DerFetzer/home-media-converter/hw/home-media-converter.ods

 | NumBoards | 5
# | Reference | Qty | Value | Footprint | QtyTotal | PN | Link
1 | C1, C2, C3, C4, C8, C9, C10, C18, C20, C22, C23, C26, C27, C29, C32, C34, C38, C39, C40, C41, C51, C52, C53, C54, C55 | 25 | 100n | Capacitor_SMD:C_0402_1005Metric | 125 | 1276-1043-1-ND | https://www.digikey.de/de/products/detail/samsung-electro-mechanics/CL05A104KA5NNNC/3886701
2 | C5, C17, C19, C24, C28, C36 | 6 | 10u | Capacitor_SMD:C_0402_1005Metric | 30 | 490-GRM155R61A106ME11DCT-ND | https://www.digikey.de/de/products/detail/murata-electronics/GRM155R61A106ME11D/12091056
3 | C6, C7, C14, C15 | 4 | 26p | Capacitor_SMD:C_0402_1005Metric | 20 | 490-GCM1555C1H270FA16JCT-ND | https://www.digikey.de/de/products/detail/murata-electronics/GCM1555C1H270FA16J/11618592
4 | C11, C37, C42, C56 | 4 | 4u7 | Capacitor_SMD:C_0402_1005Metric | 20 | 1276-1482-1-ND | https://www.digikey.de/de/products/detail/samsung-electro-mechanics/CL05A475MP5NRNC/3887140
5 | C12, C13 | 2 | 100n 1% | Capacitor_SMD:C_0402_1005Metric | 10 | 13-CC0402JRX7R8BB104CT-ND | https://www.digikey.de/de/products/detail/yageo/CC0402JRX7R8BB104/11491448
6 | C16 | 1 | 4n7 | Capacitor_SMD:C_1206_3216Metric | 5 | 732-12074-1-ND | https://www.digikey.de/de/products/detail/w%C3%BCrth-elektronik/885342208020/9345886
7 | C21, C25, C30, C35, C43, C44, C45, C62, C63 | 9 | 22u | Capacitor_SMD:C_0603_1608Metric | 45 | 1276-1274-1-ND | https://www.digikey.de/de/products/detail/samsung-electro-mechanics/CL10A226MP8NUNE/3886932
8 | C31, C46, C47, C48, C49, C50 | 6 | 10n | Capacitor_SMD:C_0402_1005Metric | 30 | 478-1114-1-ND | https://www.digikey.de/de/products/detail/kyocera-avx/0402YC103KAT2A/563224
9 | C57, C58, C60, C61 | 4 | 2u2 | Capacitor_SMD:C_0402_1005Metric | 20 | 478-CM05X5R225M16AHCT-ND | https://www.digikey.de/de/products/detail/kyocera-avx/CM05X5R225M16AH/10815099
10 | D1, D2 | 2 | 1N4148W | Diode_SMD:D_SOD-123 | 10 | 1N4148WXTPMSCT-ND | https://www.digikey.de/de/products/detail/micro-commercial-co/1N4148WX-TP/717197
11 | D3, D4, D5, D6 | 2 | LED | LED_SMD:LED_0603_1608Metric | 10 | 3147-B1911USD-20D000114U1930CT-ND | https://www.digikey.de/de/products/detail/harvatek-corporation/B1911USD-20D000114U1930/15519991
11 | D3, D4, D5, D6 | 2 | LED | LED_SMD:LED_0603_1608Metric | 10 | 3147-B1911PG--20D000514U1930CT-ND | https://www.digikey.de/de/products/detail/harvatek-corporation/B1911PG-20D000514U1930/15519992
11 | D3, D4, D5, D6 | 2 | LED | LED_SMD:LED_0603_1608Metric | 10 | 3147-B1911UYG-20D000114U1930CT-ND | https://www.digikey.de/de/products/detail/harvatek-corporation/B1911UYG-20D000114U1930/15519990
11 | D3, D4, D5, D6 | 2 | LED | LED_SMD:LED_0603_1608Metric | 10 | 3147-B1931NB--20C007614U1930CT-ND | https://www.digikey.de/de/products/detail/harvatek-corporation/B1931NB-20C007614U1930/15861263
12 | F1 | 1 | Fuse | Fuse:Fuse_0603_1608Metric | 5 | 2315-FMC16252WHTPCT-ND | https://www.digikey.de/de/products/detail/kamaya-inc/FMC16252WHTP/15181193
13 | FB1, FB2, FB3, FB4, FB5, FB6 | 3 | BLM18PG121SN1D | Inductor_SMD:L_0603_1608Metric | 15 | 490-1037-1-ND | https://www.digikey.de/de/products/detail/murata-electronics/BLM18PG121SN1D/584248
13 | FB1, FB2, FB3, FB4, FB5, FB6 | 2 | BLM18KG601SH1D | Inductor_SMD:L_0603_1608Metric | 10 | 490-13259-1-ND | https://www.digikey.de/de/products/detail/murata-electronics/BLM18KG601SH1D/5881248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
13 | FB1, FB2, FB3, FB4, FB5, FB6 | 1 | BLM18HE102SN1D | Inductor_SMD:L_0603_1608Metric | 5 | 490-5215-1-ND | https://www.digikey.de/de/products/detail/murata-electronics/BLM18HE102SN1D/1948320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
15 | J1 | 1 | 0826-1X1T-32-F | project_lib:0826-1X1T-32-F | 5 | 507-1606-ND | https://www.digikey.de/de/products/detail/bel-fuse-inc/0826-1X1T-32-F/2257873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
18 | J6 | 1 | RJ45_LED_Shielded | Connector_RJ:RJ45_Amphenol_RJHSE538X | 5 | RJHSE-5381-ND | https://www.digikey.de/de/products/detail/amphenol-cs-commercial-products/RJHSE-5381/1242694
19 | J7 | 1 | USB_B | Connector_USB:USB_Micro-B_Wuerth_629105150521 | 5 | 732-5960-1-ND | https://www.digikey.de/de/products/detail/w%C3%BCrth-elektronik/629105150521/5047751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
20 | L1 | 1 | CMC | project_lib:DLW32MH101XK2L | 5 | 490-18059-1-ND | https://www.digikey.de/de/products/detail/murata-electronics/DLW32MH101XK2L/9559534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
21 | L2, L3, L4 | 3 | 1u | Inductor_SMD:L_1008_2520Metric | 15 | 490-13053-1-ND | https://www.digikey.de/de/products/detail/murata-electronics/DFE252012F-1R0M-P2/5812589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
22 | R1, R2, R9, R10, R42, R43, R44, R45 | 8 | 470 | Resistor_SMD:R_0402_1005Metric | 40 | 2019-RK73H1ETTP4700FCT-ND | https://www.digikey.de/de/products/detail/koa-speer-electronics-inc/RK73H1ETTP4700F/9844116
23 | R3, R4, R5, R8, R12, R13 | 6 | 10k | Resistor_SMD:R_0402_1005Metric | 30 | 2019-RK73B1ETTP103JCT-ND | https://www.digikey.de/de/products/detail/koa-speer-electronics-inc/RK73B1ETTP103J/9843960
24 | R6 | 1 | 4k7 | Resistor_SMD:R_0402_1005Metric | 5 | P4.70KLCT-ND | https://www.digikey.de/de/products/detail/panasonic-electronic-components/ERJ-2RKF4701X/1746231
25 | R7 | 1 | 6k04 | Resistor_SMD:R_0402_1005Metric | 5 | 2019-RK73H1ETTP6041FCT-ND | https://www.digikey.de/de/products/detail/koa-speer-electronics-inc/RK73H1ETTP6041F/9844122
27 | R11, R14, R15, R16 | 4 | 1k | Resistor_SMD:R_0402_1005Metric | 20 | 2019-RK73H1ETTP1001FCT-ND | https://www.digikey.de/de/products/detail/koa-speer-electronics-inc/RK73H1ETTP1001F/9844155
28 | R17, R33, R35 | 3 | 2k2 | Resistor_SMD:R_0402_1005Metric | 15 | P2.20KLCT-ND | https://www.digikey.de/de/products/detail/panasonic-electronic-components/ERJ-2RKF2201X/1746150
29 | R18, R19, R20, R21, R22, R23, R24, R25, R26, R27, R28, R29 | 12 | 22 | Resistor_SMD:R_0402_1005Metric | 60 | P22.0LCT-ND | https://www.digikey.de/de/products/detail/panasonic-electronic-components/ERJ-2RKF22R0X/1746157
30 | R30, R31, R32, R39, R40, R41 | 6 | 2k49 | Resistor_SMD:R_0402_1005Metric | 30 | 2019-RK73H1ETTP2491FCT-ND | https://www.digikey.de/de/products/detail/koa-speer-electronics-inc/RK73H1ETTP2491F/9844088
31 | R34 | 1 | 13k | Resistor_SMD:R_0402_1005Metric | 5 | 2019-RK73H1ETTP1302FCT-ND | https://www.digikey.de/de/products/detail/koa-speer-electronics-inc/RK73H1ETTP1302F/9844135
32 | R36, R37 | 2 | 1k 1% | Resistor_SMD:R_1206_3216Metric | 10 | 311-1.00KFRCT-ND | https://www.digikey.de/de/products/detail/yageo/RC1206FR-071KL/728387
33 | R38 | 1 | 100k | Resistor_SMD:R_0805_2012Metric | 5 | RMCF0805FT100KCT-ND | https://www.digikey.de/de/products/detail/stackpole-electronics-inc/RMCF0805FT100K/1760712
34 | R46 | 1 | 200k | Resistor_SMD:R_0402_1005Metric | 5 | 13-AC0402FR-7W200KLCT-ND | https://www.digikey.de/de/products/detail/yageo/AC0402FR-7W200KL/12698840
35 | R47, R48, R49 | 3 | 100k | Resistor_SMD:R_0402_1005Metric | 15 | P100KLCT-ND | https://www.digikey.de/de/products/detail/panasonic-electronic-components/ERJ-2RKF1003X/192081
36 | SW1 | 1 | SW_Push | Button_Switch_SMD:SW_Push_1P1T_NO_CK_KMR2 | 5 | 401-1426-1-ND | https://www.digikey.de/de/products/detail/c-k/KMR211GLFS/550475
37 | U1 | 1 | KSZ9131RNXC-TR | project_lib:KSZ9131RNXC-TR | 5 | 150-KSZ9131RNXC-CT-ND | https://www.digikey.de/de/products/detail/microchip-technology/KSZ9131RNXC-TR/10673417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
38 | U2 | 1 | STM32F030F4Px | Package_SO:TSSOP-20_4.4x6.5mm_P0.65mm | 5 | 497-17333-1-ND | https://www.digikey.de/de/products/detail/stmicroelectronics/STM32F030F4P6TR/4755941
39 | U3 | 1 | DP83TG720RWRHATQ1 | project_lib:DP83TG720RWRHATQ1 | 5 | 296-DP83TG720RWRHATQ1CT-ND | https://www.digikey.de/de/products/detail/texas-instruments/DP83TG720RWRHATQ1/14004381
40 | U4 | 1 | AP63203WU | Package_TO_SOT_SMD:TSOT-23-6 | 5 | AP63203WU-7DICT-ND | https://www.digikey.de/de/products/detail/diodes-incorporated/AP63203WU-7/9858426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
41 | U5, U7 | 2 | TPS62A01ADRLR | project_lib:TPS62A01ADRLR | 10 | 296-TPS62A01ADRLRCT-ND | https://www.digikey.de/de/products/detail/texas-instruments/TPS62A01ADRLR/16582361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
42 | U6 | 1 | TPS784105QWDRBRQ1 | project_lib:TPS784105QWDRBRQ1 | 5 | 296-TPS784105QWDRBRQ1CT-ND | https://www.digikey.de/de/products/detail/texas-instruments/TPS784105QWDRBRQ1/14123989
43 | Y1, Y2 | 2 | 25MHz | Crystal:Crystal_SMD_5032-2Pin_5.0x3.2mm | 10 | 2151-H130A-25.000-18-F-2030-EXT-TRCT-ND | https://www.digikey.de/de/products/detail/raltron-electronics/H130A-25-000-18-F-2030-EXT-TR/10272262
