DerFetzer/home-media-converter/hw/housing/Lid (Meshed).stl

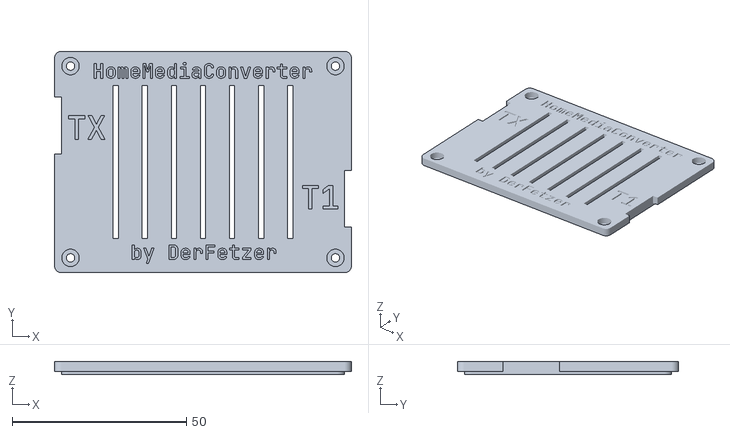
[picture p1: CAD file, 2023-04-26]
hw/housing/Lid (Meshed).stl
85.2 x 63.5 x 3.80
