DerFetzer/home-media-converter/hw/housing/HomeMediaConverterHousing.FCStd

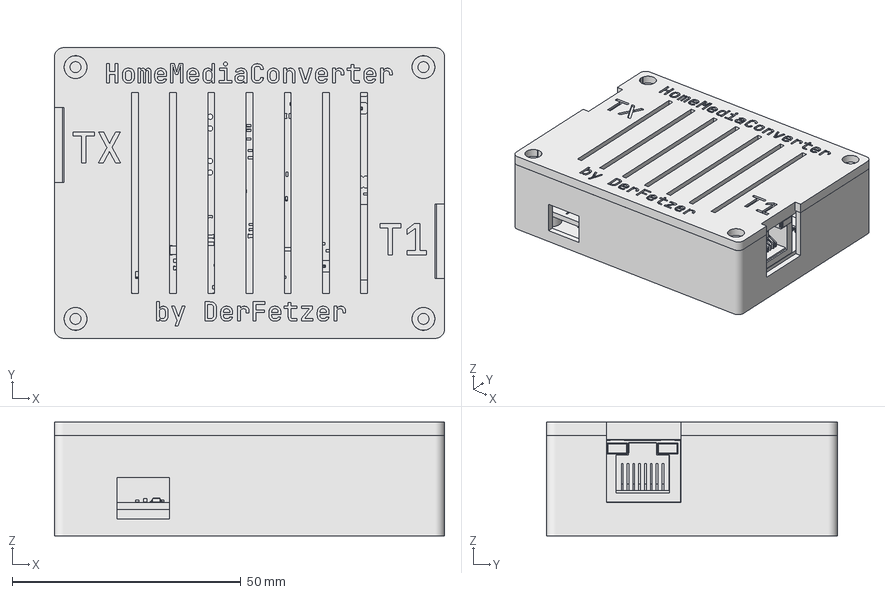
[picture p2: CAD file, 2023-04-26]
hw/housing/HomeMediaConverterHousing.FCStd
85.2 x 63.5 x 24.8 mm
Lid
home-media-converter
Lid (Meshed)
Bottom (Meshed)
