DerFetzer/home-media-converter/hw/housing/Bottom (Meshed).stl

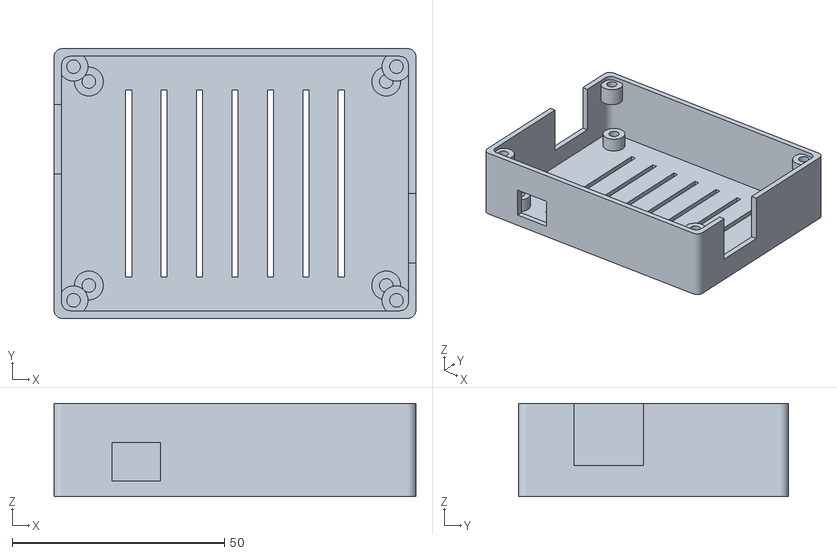
[picture p3: CAD file, 2023-04-26]
hw/housing/Bottom (Meshed).stl
85.2 x 63.5 x 21.9
