DerFetzer/home-media-converter/hw/pcb/home-media-converter.kicad_pcb

## KiCad design hw/pcb/home-media-converter.kicad_pcb (2023-05-08)

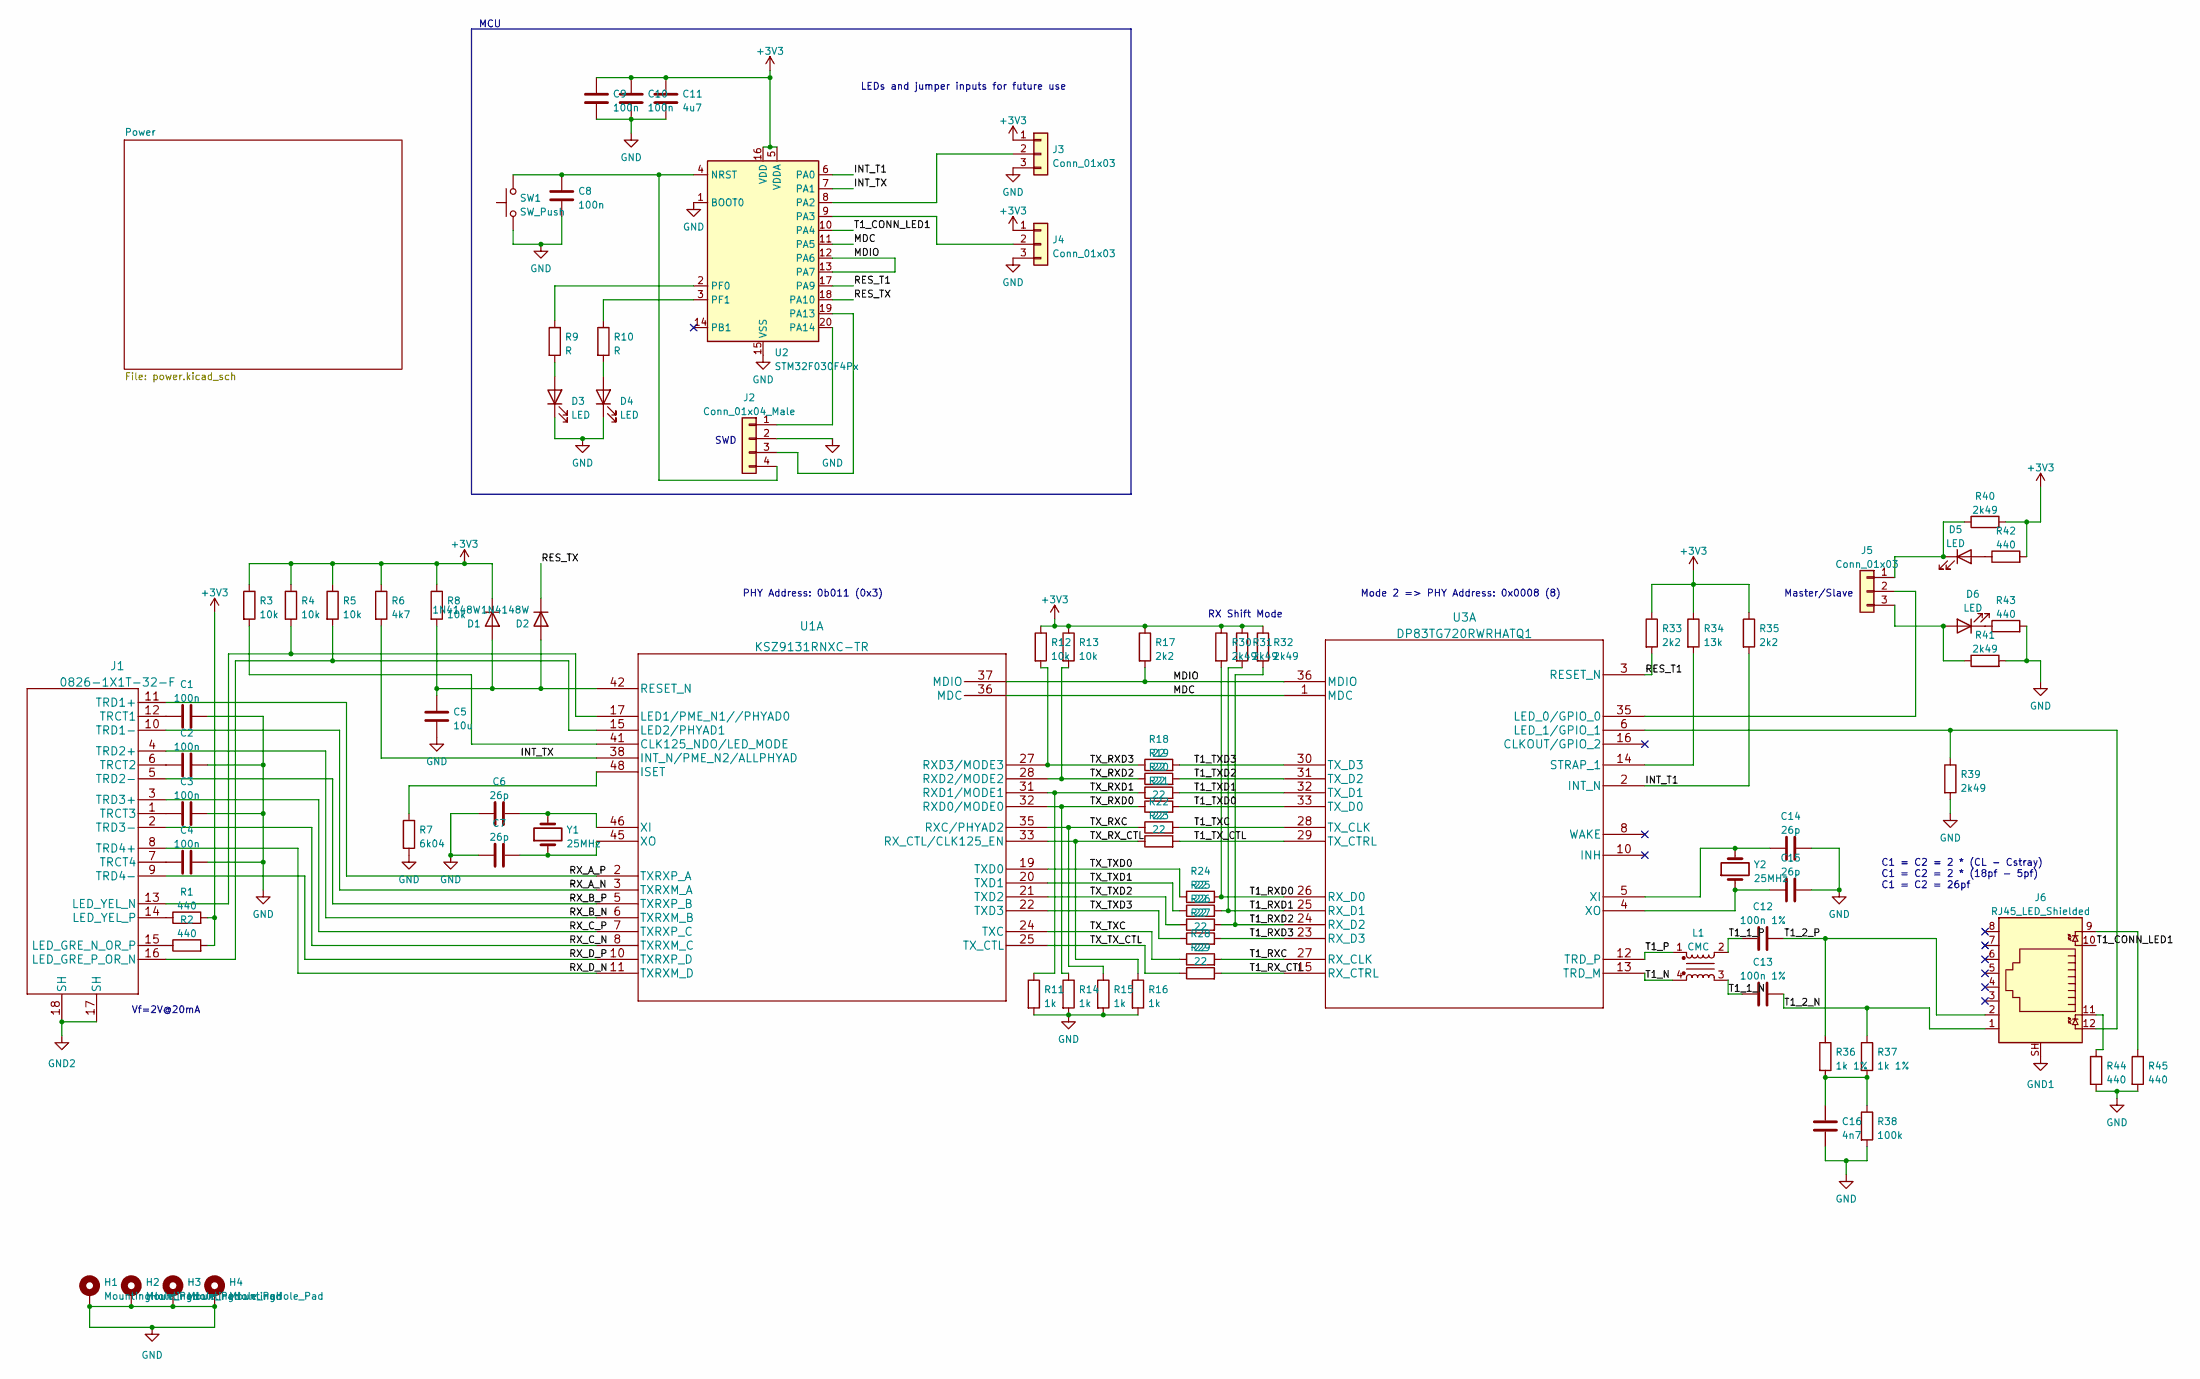
[picture p4: schematic home-media-converter.kicad_sch]

Parts:
C1, C2, C3, C4, C8, C9, C10: 100n; C_0402_1005Metric
C5: 10u; C_0402_1005Metric
C6, C7, C14, C15: 26p; C_0402_1005Metric
C11: 4u7; C_0402_1005Metric
C12, C13: 100n 1%; C_0402_1005Metric
C16: 4n7; C_1206_3216Metric
D1, D2: 1N4148W; D_SOD-123
D3, D4, D5, D6: LED; LED_0603_1608Metric
H1, H2, H3, H4: MountingHole_Pad; MountingHole_2.2mm_M2_DIN965_Pad_TopBottom
J1: 0826-1X1T-32-F
J2: Conn_01x04_Male; PinHeader_1x04_P2.54mm_Vertical
J3, J4, J5: Conn_01x03; PinHeader_1x03_P2.54mm_Vertical
J6: RJ45_LED_Shielded; RJ45_Amphenol_RJHSE538X
L1: CMC; DLW32MH101XK2L
R1, R2, R42, R43, R44, R45: 440; R_0402_1005Metric
R3, R4, R5, R8, R12, R13: 10k; R_0402_1005Metric
R6: 4k7; R_0402_1005Metric
R7: 6k04; R_0402_1005Metric
R9, R10: R; R_0402_1005Metric
R11, R14, R15, R16: 1k; R_0402_1005Metric
R17, R33, R35: 2k2; R_0402_1005Metric
R18, R19, R20, R21, R22, R23, R24, R25, R26, R27, R28, R29: 22; R_0402_1005Metric
R30, R31, R32, R39, R40, R41: 2k49; R_0402_1005Metric
R34: 13k; R_0402_1005Metric
R36, R37: 1k 1%; R_1206_3216Metric
R38: 100k; R_0805_2012Metric
SW1: SW_Push; SW_Push_1P1T_NO_CK_KMR2
U1: KSZ9131RNXC-TR
U2: STM32F030F4Px; TSSOP-20_4.4x6.5mm_P0.65mm
U3: DP83TG720RWRHATQ1
Y1, Y2: 25MHz; Crystal_SMD_5032-2Pin_5.0x3.2mm

Connections:
+3V3: C9.1, C10.1, C11.1, D1.1 (K), J3.1, J4.1, R1.2, R2.2, R3.1, R4.1, R5.1, R6.1, R8.1, R12.1, R13.1, R17.1, R30.1, R31.1, R32.1, R33.1, R34.1, R35.1, R40.2, R42.2, U2.5 (VDDA), U2.16 (VDD); also elsewhere on the board
/INT_T1: R35.2, U2.6 (PA0), U3.2 (INT_N)
/INT_TX: R6.2, U1.38 (INT_N/PME_N2/ALLPHYAD), U2.7 (PA1)
/MDC: U1.36 (MDC), U2.11 (PA5), U3.1 (MDC)
/MDIO: R17.2, U1.37 (MDIO), U2.12 (PA6), U2.13 (PA7), U3.36 (MDIO)
/RES_T1: R33.2, U2.17 (PA9), U3.3 (RESET_N)
/RES_TX: D2.1 (K), U2.18 (PA10)
/RX_A_N: J1.10 (TRD1-), U1.3 (TXRXM_A); also elsewhere on the board
/RX_A_P: J1.11 (TRD1+), U1.2 (TXRXP_A); also elsewhere on the board
/RX_B_N: J1.4 (TRD2+), U1.6 (TXRXM_B); also elsewhere on the board
/RX_B_P: J1.5 (TRD2-), U1.5 (TXRXP_B); also elsewhere on the board
/RX_C_N: J1.2 (TRD3-), U1.8 (TXRXM_C); also elsewhere on the board
/RX_C_P: J1.3 (TRD3+), U1.7 (TXRXP_C); also elsewhere on the board
/RX_D_N: J1.8 (TRD4+), U1.11 (TXRXM_D); also elsewhere on the board
/RX_D_P: J1.9 (TRD4-), U1.10 (TXRXP_D); also elsewhere on the board
/T1_1_N: C13.1, L1.3
/T1_1_P: C12.1, L1.2
/T1_2_N: C13.2, J6.1, R37.1
/T1_2_P: C12.2, J6.2, R36.1
/T1_CONN_LED1: J6.10, U2.10 (PA4)
/T1_N: L1.4, U3.13 (TRD_M)
/T1_P: L1.1, U3.12 (TRD_P)
/T1_RXC: R28.2, U3.27 (RX_CLK)
/T1_RXD0: R24.2, R30.2, U3.26 (RX_D0)
/T1_RXD1: R25.2, R31.2, U3.25 (RX_D1)
/T1_RXD2: R26.2, R32.2, U3.24 (RX_D2)
/T1_RXD3: R27.2, U3.23 (RX_D3)
/T1_RX_CTL: R29.2, U3.15 (RX_CTRL)
/T1_TXC: R22.2, U3.28 (TX_CLK)
/T1_TXD0: R21.2, U3.33 (TX_D0)
/T1_TXD1: R20.2, U3.32 (TX_D1)
/T1_TXD2: R19.2, U3.31 (TX_D2)
/T1_TXD3: R18.2, U3.30 (TX_D3)
/T1_TX_CTL: R23.2, U3.29 (TX_CTRL)
/TX_RXC: R15.1, R22.1, U1.35 (RXC/PHYAD2)
/TX_RXD0: R14.1, R21.1, U1.32 (RXD0/MODE0)
/TX_RXD1: R11.1, R20.1, U1.31 (RXD1/MODE1)
/TX_RXD2: R13.2, R19.1, U1.28 (RXD2/MODE2)
/TX_RXD3: R12.2, R18.1, U1.27 (RXD3/MODE3)
/TX_RX_CTL: R16.1, R23.1, U1.33 (RX_CTL/CLK125_EN)
/TX_TXC: R28.1, U1.24 (TXC)
/TX_TXD0: R24.1, U1.19 (TXD0)
/TX_TXD1: R25.1, U1.20 (TXD1)
/TX_TXD2: R26.1, U1.21 (TXD2)
/TX_TXD3: R27.1, U1.22 (TXD3)
/TX_TX_CTL: R29.1, U1.25 (TX_CTL)
GND: C1.2, C2.2, C3.2, C4.2, C5.2, C6.1, C7.1, C8.2, C9.2, C10.2, C11.2, C14.2, C15.2, C16.2, D3.1 (K), D4.1 (K), H1.1, H2.1, H3.1, H4.1, J2.2, J3.3, J4.3, R7.2, R11.2, R14.2, R15.2, R16.2, R38.2, R39.2, R41.2, R43.2, R44.2, R45.2, SW1.1, U2.1 (BOOT0), U2.15 (VSS); also elsewhere on the board
GND1: J6.SH
unnamed: C16.1, R36.2, R37.2, R38.1
unnamed: C5.1, D1.2 (A), D2.2 (A), R8.2, U1.42 (RESET_N)
unnamed: D3.2 (A), R9.2
unnamed: D4.2 (A), R10.2
unnamed: D5.2 (A), R42.1
unnamed: D5.1 (K), J5.1, R40.1
unnamed: D6.2 (A), J5.3, R41.1
unnamed: D6.1 (K), R43.1
unnamed 66: J1.15 (LED_GRE_N_OR_P), R2.1; also elsewhere on the board
unnamed 67: J1.16 (LED_GRE_P_OR_N), R5.2, U1.15 (LED2/PHYAD1); also elsewhere on the board
unnamed 68: J1.13 (LED_YEL_N), R4.2, U1.17 (LED1/PME_N1//PHYAD0); also elsewhere on the board
unnamed 69: J1.14 (LED_YEL_P), R1.1; also elsewhere on the board
unnamed: J1.17 (SH), J1.18 (SH)
unnamed 71: C1.1, J1.12 (TRCT1); also elsewhere on the board
unnamed 72: C2.1, J1.6 (TRCT2); also elsewhere on the board
unnamed 73: C3.1, J1.1 (TRCT3); also elsewhere on the board
unnamed 74: C4.1, J1.7 (TRCT4); also elsewhere on the board
unnamed: J2.1, U2.20 (PA14)
unnamed: J2.3, U2.19 (PA13)
unnamed: C8.1, J2.4, SW1.2, U2.4 (NRST)
unnamed: J3.2, U2.8 (PA2)
unnamed: J4.2, U2.9 (PA3)
unnamed: J5.2, U3.35 (LED_0/GPIO_0)
unnamed: J6.9, R45.1
unnamed: J6.11, R44.1
unnamed: R3.2, U1.41 (CLK125_NDO/LED_MODE)
unnamed: R7.1, U1.48 (ISET)
unnamed: C6.2, U1.46 (XI), Y1.2
unnamed: C7.2, U1.45 (XO), Y1.1
unnamed: R9.1, U2.2 (PF0)
unnamed: R10.1, U2.3 (PF1)
unnamed: J6.12, R39.1, U3.6 (LED_1/GPIO_1)
unnamed: R34.2, U3.14 (STRAP_1)
unnamed: C14.1, U3.5 (XI), Y2.2
unnamed: C15.1, U3.4 (XO), Y2.1

Notes on the sheet:
Vf=2V@20mA
LEDs and jumper inputs for future use
Mode 2 => PHY Address: 0x0008 (8)
C1 = C2 = 2 * (CL - Cstray) C1 = C2 = 2 * (18pf - 5pf) C1 = C2 = 26pf
SWD
RX Shift Mode
PHY Address: 0b011 (0x3)
MCU
Master/Slave

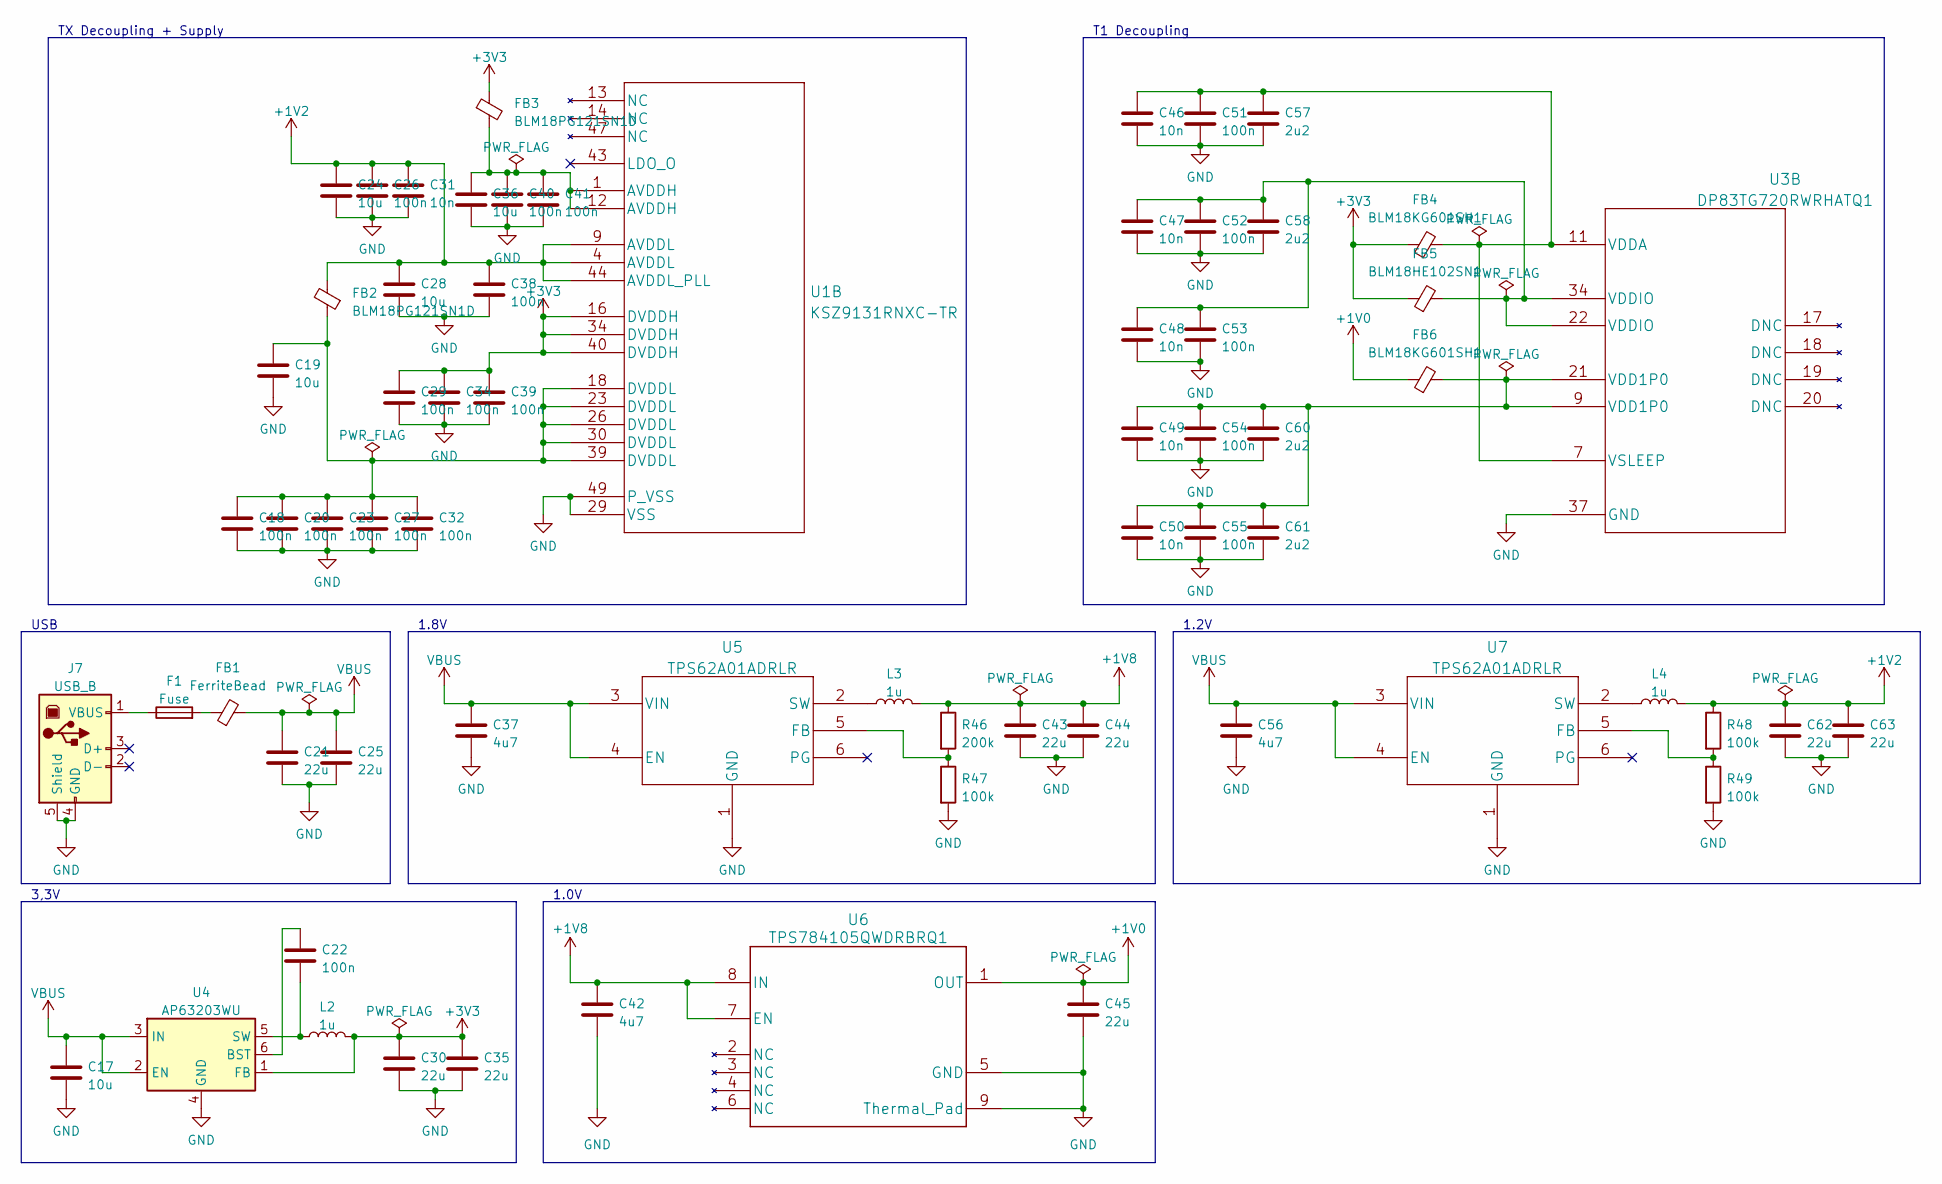
[picture p5: schematic power.kicad_sch]

Parts:
C17, C19, C24, C28, C36: 10u; C_0402_1005Metric
C18, C20, C22, C23, C26, C27, C29, C32, C34, C38, C39, C40, C41, C51, C52, C53, C54, C55: 100n; C_0402_1005Metric
C21, C25, C30, C35, C43, C44, C45, C62, C63: 22u; C_0603_1608Metric
C31, C46, C47, C48, C49, C50: 10n; C_0402_1005Metric
C37, C42, C56: 4u7; C_0402_1005Metric
C57, C58, C60, C61: 2u2; C_0402_1005Metric
F1: Fuse; Fuse_0603_1608Metric
FB1: FerriteBead; L_0603_1608Metric
FB2, FB3: BLM18PG121SN1D; L_0603_1608Metric
FB4, FB6: BLM18KG601SH1; L_0603_1608Metric
FB5: BLM18HE102SN1; L_0603_1608Metric
J7: USB_B; USB_Micro-B_Wuerth_629105150521
L2, L3, L4: 1u; L_1008_2520Metric
R46: 200k; R_0402_1005Metric
R47, R48, R49: 100k; R_0402_1005Metric
U1: KSZ9131RNXC-TR
U3: DP83TG720RWRHATQ1
U4: AP63203WU; TSOT-23-6
U5, U7: TPS62A01ADRLR
U6: TPS784105QWDRBRQ1

Connections:
+1V0: C45.1, FB6.1, U6.1 (OUT)
+1V2: C24.1, C26.1, C28.1, C31.1, C38.1, C62.1, C63.1, FB2.2, L4.2, R48.1, U1.4 (AVDDL), U1.9 (AVDDL), U1.44 (AVDDL_PLL)
+1V8: C42.1, C43.1, C44.1, L3.2, R46.1, U6.7 (EN), U6.8 (IN)
+3V3: C29.1, C30.1, C34.1, C35.1, C39.1, FB3.1, FB4.1, FB5.1, L2.2, U1.16 (DVDDH), U1.34 (DVDDH), U1.40 (DVDDH), U4.1 (FB); also elsewhere on the board
GND: C17.2, C18.2, C19.2, C20.2, C21.2, C23.2, C24.2, C25.2, C26.2, C27.2, C28.2, C29.2, C30.2, C31.2, C32.2, C34.2, C35.2, C36.2, C37.2, C38.2, C39.2, C40.2, C41.2, C42.2, C43.2, C44.2, C45.2, C46.2, C47.2, C48.2, C49.2, C50.2, C51.2, C52.2, C53.2, C54.2, C55.2, C56.2, C57.2, C58.2, C60.2, C61.2, C62.2, C63.2, J7.4 (GND), J7.5 (Shield), R47.2, R49.2, U1.29 (VSS), U1.49 (P_VSS), U3.37 (GND), U4.4 (GND), U5.1 (GND), U6.5 (GND), U6.9 (Thermal_Pad), U7.1 (GND); also elsewhere on the board
unnamed: C18.1, C19.1, C20.1, C23.1, C27.1, C32.1, FB2.1, U1.18 (DVDDL), U1.23 (DVDDL), U1.26 (DVDDL), U1.30 (DVDDL), U1.39 (DVDDL)
unnamed: C36.1, C40.1, C41.1, FB3.2, U1.1 (AVDDH), U1.12 (AVDDH)
unnamed: C46.1, C51.1, C57.1, FB4.2, U3.7 (VSLEEP), U3.11 (VDDA)
unnamed: C47.1, C48.1, C52.1, C53.1, C58.1, FB5.2, U3.22 (VDDIO), U3.34 (VDDIO)
unnamed: C49.1, C50.1, C54.1, C55.1, C60.1, C61.1, FB6.2, U3.9 (VDD1P0), U3.21 (VDD1P0)
unnamed: F1.2, FB1.1
unnamed: F1.1, J7.1 (VBUS)
unnamed: C22.1, U4.6 (BST)
unnamed: C22.2, L2.1, U4.5 (SW)
unnamed: R46.2, R47.1, U5.5 (FB)
unnamed: L3.1, U5.2 (SW)
unnamed: R48.2, R49.1, U7.5 (FB)
unnamed: L4.1, U7.2 (SW)
VBUS: C17.1, C21.1, C25.1, C37.1, C56.1, FB1.2, U4.2 (EN), U4.3 (IN), U5.3 (VIN), U5.4 (EN), U7.3 (VIN), U7.4 (EN)

Notes on the sheet:
USB
TX Decoupling + Supply
1.0V
1.2V
3,3V
1.8V
T1 Decoupling

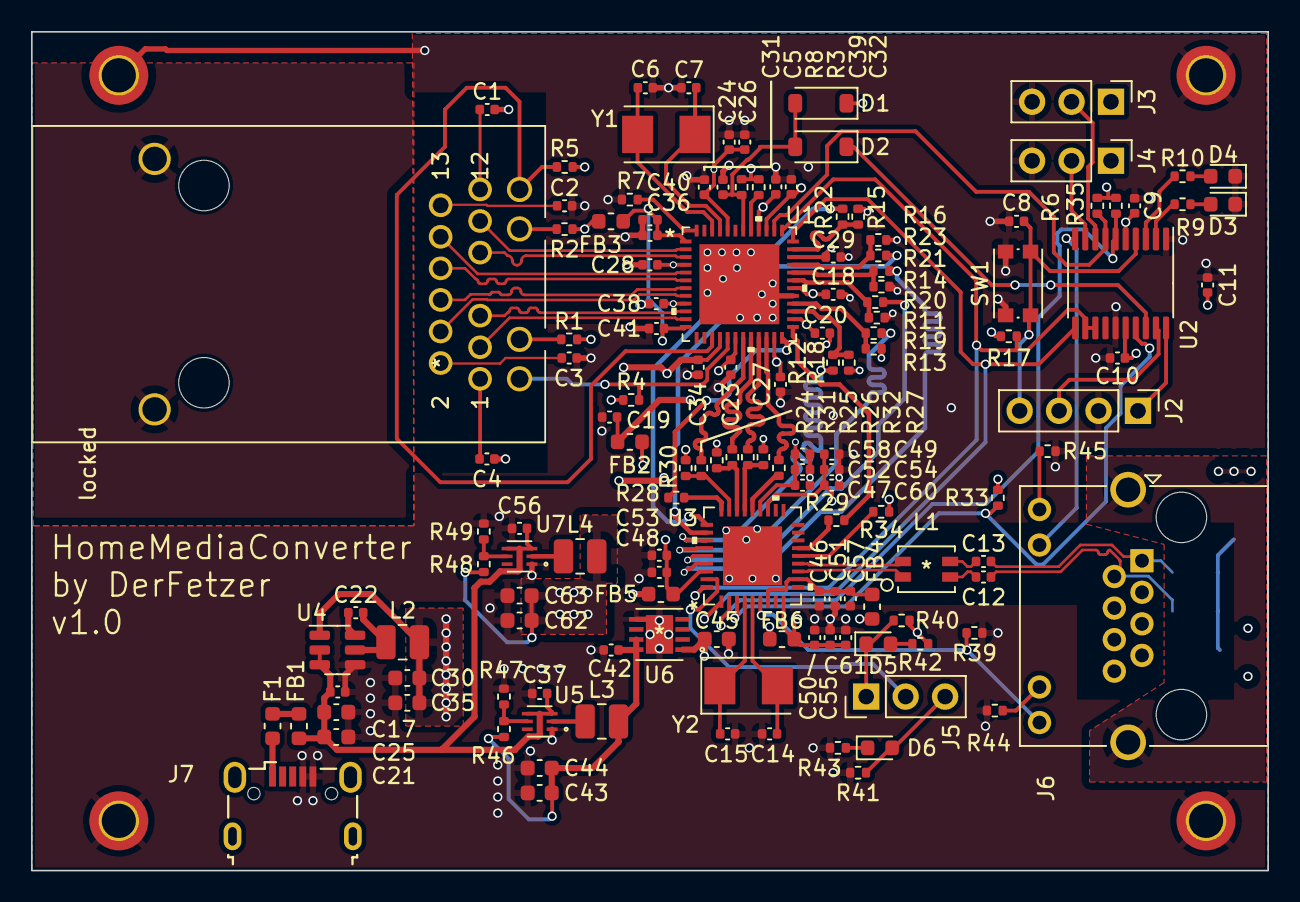
[picture p6: board home-media-converter.kicad_pcb from above]

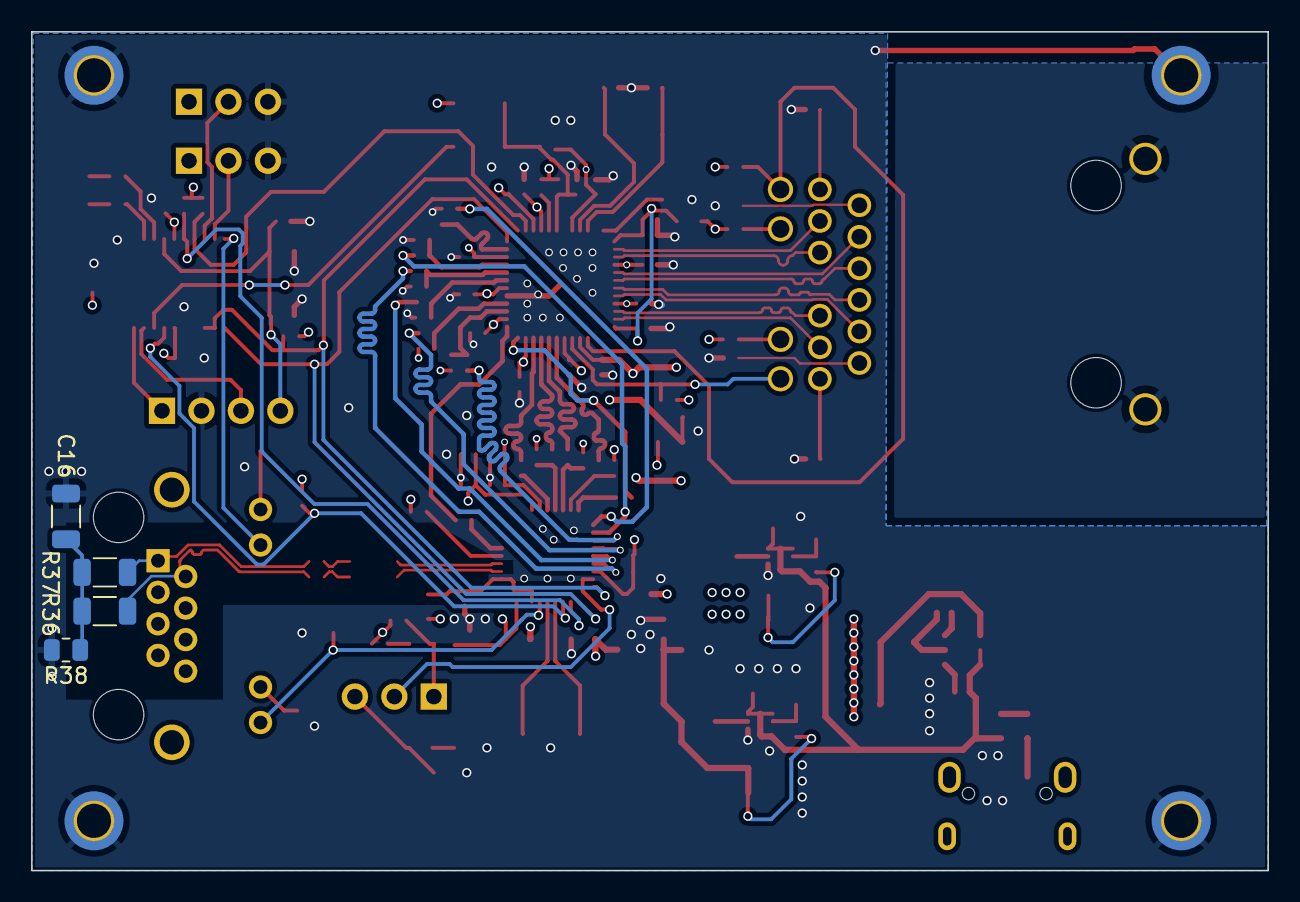
[picture p7: board home-media-converter.kicad_pcb from below]

Board: 4 copper layers, 79.6 x 54.0 mm, 148 parts (4 on the bottom side), 99 nets.

Other parts of the board:
locked: 0826-1X1T-32-F

Their connections:
/RX_A_N: locked.10 (TRD1-); also elsewhere on the board
/RX_A_P: locked.11 (TRD1+); also elsewhere on the board
/RX_B_N: locked.4 (TRD2+); also elsewhere on the board
/RX_B_P: locked.5 (TRD2-); also elsewhere on the board
/RX_C_N: locked.2 (TRD3-); also elsewhere on the board
/RX_C_P: locked.3 (TRD3+); also elsewhere on the board
/RX_D_N: locked.8 (TRD4+); also elsewhere on the board
/RX_D_P: locked.9 (TRD4-); also elsewhere on the board
GND2: locked.17 (SH), locked.18 (SH)
unnamed 66: locked.15 (LED_GRE_N_OR_P); also elsewhere on the board
unnamed 67: locked.16 (LED_GRE_P_OR_N); also elsewhere on the board
unnamed 68: locked.13 (LED_YEL_N); also elsewhere on the board
unnamed 69: locked.14 (LED_YEL_P); also elsewhere on the board
unnamed 71: locked.12 (TRCT1); also elsewhere on the board
unnamed 72: locked.6 (TRCT2); also elsewhere on the board
unnamed 73: locked.1 (TRCT3); also elsewhere on the board
unnamed 74: locked.7 (TRCT4); also elsewhere on the board
