DerFetzer/home-media-converter/(commit log)

2023-03-29 Initial PCB design
    [home-media-converter.kicad_pcb, home-media-converter.kicad_sch, power.kicad_sch]
2023-03-30 Bigger components on MDI
    [home-media-converter.kicad_pcb, home-media-converter.kicad_sch]
2023-03-30 Add production files
    [home-media-converter-B_Cu.gbl, home-media-converter-B_Mask.gbs, home-media-converter-B_Paste.gbp, home-media-converter-B_Silkscreen.gbo, home-media-converter-Edge_Cuts.gm1, home-media-converter-F_Cu.gtl, home-media-converter-F_Mask.gts, home-media-converter-F_Paste.gtp]
2023-03-30 Plot params
    [home-media-converter.kicad_pcb]
2023-04-05 Set missing part values, create BOM
    [home-media-converter.kicad_sch, home-media-converter.ods, power.kicad_sch]
2023-04-21 Fix MagJack LED polarity
    [home-media-converter.kicad_pcb, home-media-converter.kicad_sch]
2023-04-23 Slower blinking of SQI LED
2023-04-23 Move PCB to subdirectory
    [home-media-converter-B_Cu.gbl, home-media-converter-B_Mask.gbs, home-media-converter-B_Paste.gbp, home-media-converter-B_Silkscreen.gbo, home-media-converter-Edge_Cuts.gm1, home-media-converter-F_Cu.gtl, home-media-converter-F_Mask.gts, home-media-converter-F_Paste.gtp]
2023-04-26 Add housing
    [Bottom (Meshed).stl, HomeMediaConverterHousing.FCStd, Lid (Meshed).stl]
2023-05-08 Add description to silkscreen
    [home-media-converter.kicad_pcb]
2023-05-08 Modify gitignore, remove production files as they are not automatically updated
    [home-media-converter-B_Cu.gbl, home-media-converter-B_Mask.gbs, home-media-converter-B_Paste.gbp, home-media-converter-B_Silkscreen.gbo, home-media-converter-Edge_Cuts.gm1, home-media-converter-F_Cu.gtl, home-media-converter-F_Mask.gts, home-media-converter-F_Paste.gtp]
2023-05-08 Fix missing part numbers and BOM
    [home-media-converter.ods, power.kicad_sch]
2023-05-08 Modify BOM
    [home-media-converter.ods]
